cyfinfaza/RSC-LV3-Dash/changelog.md

### Revision 1

* Add SAI interface
* Expose I2C interface from CTP (no other interfaces are available on the MCU)
* Add BKLT\_ENABLE pull-down resistor (previously was only pull-up) for default dark screen
* Minor placement and silkscreen modifications
