cyfinfaza/RSC-LV3-Dash/LV3-Dash-CubeMX/pinout-formatted.csv

Position | Name | Signal | Type | Label | AF0 | AF1 | AF2 | AF3 | AF4 | AF5 | AF6 | AF7 | AF8 | AF9 | AF10 | AF11 | AF12 | AF13 | AF14
94 | BOOT0 |  | Boot
14 | NRST |  | Reset
22 | PA00 |  | I/O |  |  | TIM2_CH1/TIM2_ETR | TIM5_CH1 | TIM8_ETR | TIM15_BKIN |  |  | USART2_CTS/USART2_NSS | UART4_TX | SDMMC2_CMD | SAI2_SD_B | ETH_CRS
23 | PA01 | LTDC_R2 | I/O |  |  | TIM2_CH2 | TIM5_CH2 | LPTIM3_OUT | TIM15_CH1N |  |  | USART2_DE/USART2_RTS | UART4_RX | QUADSPI_BK1_IO3 | SAI2_MCLK_B | ETH_REF_CLK/ETH_RX_CLK |  |  | LTDC_R2
24 | PA02 | LTDC_R1 | I/O |  |  | TIM2_CH3 | TIM5_CH3 | LPTIM4_OUT | TIM15_CH1 |  |  | USART2_TX | SAI2_SCK_B |  |  | ETH_MDIO | MDIOS_MDIO |  | LTDC_R1
25 | PA03 | LTDC_B5 | I/O |  |  | TIM2_CH4 | TIM5_CH4 | LPTIM5_OUT | TIM15_CH2 |  |  | USART2_RX |  | LTDC_B2 | USB_OTG_HS_ULPI_D0 | ETH_COL |  |  | LTDC_B5
28 | PA04 | LTDC_VSYNC | I/O |  |  |  | TIM5_ETR |  |  | I2S1_WS/SPI1_NSS | I2S3_WS/SPI3_NSS | USART2_CK | SPI6_NSS |  |  |  | USB_OTG_HS_SOF | DCMI_HSYNC | LTDC_VSYNC
29 | PA05 | LTDC_R4 | I/O |  |  | TIM2_CH1/TIM2_ETR |  | TIM8_CH1N |  | I2S1_CK/SPI1_SCK |  |  | SPI6_SCK |  | USB_OTG_HS_ULPI_CK |  |  |  | LTDC_R4
30 | PA06 | LTDC_G2 | I/O |  |  | TIM1_BKIN | TIM3_CH1 | TIM8_BKIN |  | I2S1_SDI/SPI1_MISO |  |  | SPI6_MISO | TIM13_CH1 | TIM8_BKIN_COMP1/TIM8_BKIN_COMP2 | MDIOS_MDC | TIM1_BKIN_COMP1/TIM1_BKIN_COMP2 | DCMI_PIXCLK | LTDC_G2
31 | PA07 | I2S1_SDO | I/O |  |  | TIM1_CH1N | TIM3_CH2 | TIM8_CH1N |  | I2S1_SDO/SPI1_MOSI |  |  | SPI6_MOSI | TIM14_CH1 |  | ETH_CRS_DV/ETH_RX_DV | FMC_SDNWE
67 | PA08 | LTDC_R6 | I/O |  | RCC_MCO_1 | TIM1_CH1 | HRTIM_CHB2 | TIM8_BKIN2 | I2C3_SCL |  |  | USART1_CK |  |  | USB_OTG_FS_SOF | UART7_RX | TIM8_BKIN2_COMP1/TIM8_BKIN2_COMP2 | LTDC_B3 | LTDC_R6
68 | PA09 |  | I/O |  |  | TIM1_CH2 | HRTIM_CHC1 | LPUART1_TX | I2C3_SMBA | I2S2_CK/SPI2_SCK |  | USART1_TX |  |  |  | ETH_TX_ER |  | DCMI_D0 | LTDC_R5
69 | PA10 |  | I/O |  |  | TIM1_CH3 | HRTIM_CHC2 | LPUART1_RX |  |  |  | USART1_RX |  |  | USB_OTG_FS_ID | MDIOS_MDIO | LTDC_B4 | DCMI_D1 | LTDC_B1
70 | PA11 | USB_OTG_FS_DM | I/O |  |  | TIM1_CH4 | HRTIM_CHD1 | LPUART1_CTS |  | I2S2_WS/SPI2_NSS | UART4_RX | USART1_CTS/USART1_NSS |  | FDCAN1_RX | USB_OTG_FS_DM |  |  |  | LTDC_R4
71 | PA12 | USB_OTG_FS_DP | I/O |  |  | TIM1_ETR | HRTIM_CHD2 | LPUART1_DE/LPUART1_RTS |  | I2S2_CK/SPI2_SCK | UART4_TX | USART1_DE/USART1_RTS | SAI2_FS_B | FDCAN1_TX | USB_OTG_FS_DP |  |  |  | LTDC_R5
72 | PA13 (JTMS/SWDIO) | DEBUG_JTMS-SWDIO | I/O |  | DEBUG_JTMS-SWDIO
76 | PA14 (JTCK/SWCLK) | DEBUG_JTCK-SWCLK | I/O |  | DEBUG_JTCK-SWCLK
77 | PA15 (JTDI) | I2S1_WS | I/O |  | DEBUG_JTDI | TIM2_CH1/TIM2_ETR | HRTIM_FLT1 |  | CEC | I2S1_WS/SPI1_NSS | I2S3_WS/SPI3_NSS | SPI6_NSS | UART4_DE/UART4_RTS |  |  | UART7_TX
34 | PB00 | LTDC_R3 | I/O |  |  | TIM1_CH2N | TIM3_CH3 | TIM8_CH2N |  |  | DFSDM1_CKOUT |  | UART4_CTS | LTDC_R3 | USB_OTG_HS_ULPI_D1 | ETH_RXD2 |  |  | LTDC_G1
35 | PB01 | ADC1_INP5 | I/O | V_SENSE_12 |  | TIM1_CH3N | TIM3_CH4 | TIM8_CH3N |  |  | DFSDM1_DATIN1 |  |  | LTDC_R6 | USB_OTG_HS_ULPI_D2 | ETH_RXD3 |  |  | LTDC_G0
36 | PB02 |  | I/O |  | RTC_OUT_ALARM/RTC_OUT_CALIB |  | SAI1_D1 |  | DFSDM1_CKIN1 |  | SAI1_SD_A | I2S3_SDO/SPI3_MOSI | SAI4_SD_A | QUADSPI_CLK | SAI4_D1 | ETH_TX_ER
89 | PB03 (JTDO/TRACESWO) | I2S1_CK | I/O |  | DEBUG_JTDO-SWO | TIM2_CH2 | HRTIM_FLT4 |  |  | I2S1_CK/SPI1_SCK | I2S3_CK/SPI3_SCK |  | SPI6_SCK | SDMMC2_D2 | CRS_SYNC | UART7_RX
90 | PB04 (NJTRST) |  | I/O |  |  | TIM16_BKIN | TIM3_CH1 | HRTIM_EEV6 |  | I2S1_SDI/SPI1_MISO | I2S3_SDI/SPI3_MISO | I2S2_WS/SPI2_NSS | SPI6_MISO | SDMMC2_D3 |  | UART7_TX
91 | PB05 |  | I/O |  |  | TIM17_BKIN | TIM3_CH2 | HRTIM_EEV7 | I2C1_SMBA | I2S1_SDO/SPI1_MOSI | I2C4_SMBA | I2S3_SDO/SPI3_MOSI | SPI6_MOSI | FDCAN2_RX | USB_OTG_HS_ULPI_D7 | ETH_PPS_OUT | FMC_SDCKE1 | DCMI_D10 | UART5_RX
92 | PB06 | FDCAN2_TX | I/O |  |  | TIM16_CH1N | TIM4_CH1 | HRTIM_EEV8 | I2C1_SCL | CEC | I2C4_SCL | USART1_TX | LPUART1_TX | FDCAN2_TX | QUADSPI_BK1_NCS | DFSDM1_DATIN5 | FMC_SDNE1 | DCMI_D5 | UART5_TX
93 | PB07 | GPIO_Input | Input | BOOT0_SENSE |  | TIM17_CH1N | TIM4_CH2 | HRTIM_EEV9 | I2C1_SDA |  | I2C4_SDA | USART1_RX | LPUART1_RX |  |  | DFSDM1_CKIN5 | FMC_NL | DCMI_VSYNC
95 | PB08 | LTDC_B6 | I/O |  |  | TIM16_CH1 | TIM4_CH3 | DFSDM1_CKIN7 | I2C1_SCL |  | I2C4_SCL | SDMMC1_CKIN | UART4_RX | FDCAN1_RX | SDMMC2_D4 | ETH_TXD3 | SDMMC1_D4 | DCMI_D6 | LTDC_B6
96 | PB09 | LTDC_B7 | I/O |  |  | TIM17_CH1 | TIM4_CH4 | DFSDM1_DATIN7 | I2C1_SDA | I2S2_WS/SPI2_NSS | I2C4_SDA | SDMMC1_CDIR | UART4_TX | FDCAN1_TX | SDMMC2_D5 | I2C4_SMBA | SDMMC1_D5 | DCMI_D7 | LTDC_B7
46 | PB10 | LTDC_G4 | I/O |  |  | TIM2_CH3 | HRTIM_SCOUT | LPTIM2_IN1 | I2C2_SCL | I2S2_CK/SPI2_SCK | DFSDM1_DATIN7 | USART3_TX |  | QUADSPI_BK1_NCS | USB_OTG_HS_ULPI_D3 | ETH_RX_ER |  |  | LTDC_G4
47 | PB11 | LTDC_G5 | I/O |  |  | TIM2_CH4 | HRTIM_SCIN | LPTIM2_ETR | I2C2_SDA |  | DFSDM1_CKIN7 | USART3_RX |  |  | USB_OTG_HS_ULPI_D4 | ETH_TX_EN |  |  | LTDC_G5
51 | PB12 | FDCAN2_RX | I/O |  |  | TIM1_BKIN |  |  | I2C2_SMBA | I2S2_WS/SPI2_NSS | DFSDM1_DATIN1 | USART3_CK |  | FDCAN2_RX | USB_OTG_HS_ULPI_D5 | ETH_TXD0 | USB_OTG_HS_ID | TIM1_BKIN_COMP1/TIM1_BKIN_COMP2 | UART5_RX
52 | PB13 | SPI2_SCK | I/O |  |  | TIM1_CH1N |  | LPTIM2_OUT |  | I2S2_CK/SPI2_SCK | DFSDM1_CKIN1 | USART3_CTS/USART3_NSS |  | FDCAN2_TX | USB_OTG_HS_ULPI_D6 | ETH_TXD1 |  |  | UART5_TX
53 | PB14 | SPI2_MISO | I/O |  |  | TIM1_CH2N | TIM12_CH1 | TIM8_CH2N | USART1_TX | I2S2_SDI/SPI2_MISO | DFSDM1_DATIN2 | USART3_DE/USART3_RTS | UART4_DE/UART4_RTS | SDMMC2_D0 |  |  | USB_OTG_HS_DM
54 | PB15 | GPIO_Output | Output | SD_CS | RTC_REFIN | TIM1_CH3N | TIM12_CH2 | TIM8_CH3N | USART1_RX | I2S2_SDO/SPI2_MOSI | DFSDM1_CKIN2 |  | UART4_CTS | SDMMC2_D1 |  |  | USB_OTG_HS_DP
15 | PC00 | LTDC_R5 | I/O |  |  |  |  | DFSDM1_CKIN0 |  |  | DFSDM1_DATIN4 |  | SAI2_FS_B |  | USB_OTG_HS_ULPI_STP |  | FMC_SDNWE |  | LTDC_R5
16 | PC01 | SPI2_MOSI | I/O |  | DEBUG_TRACED0 |  | SAI1_D1 | DFSDM1_DATIN0 | DFSDM1_CKIN4 | I2S2_SDO/SPI2_MOSI | SAI1_SD_A |  | SAI4_SD_A | SDMMC2_CK | SAI4_D1 | ETH_MDC | MDIOS_MDC
32 | PC04 | ADC1_INP4 | I/O | V_SENSE_5 |  |  |  | DFSDM1_CKIN2 |  | I2S1_MCK |  |  |  | SPDIFRX1_IN2 |  | ETH_RXD0 | FMC_SDNE0
33 | PC05 |  | I/O |  |  |  | SAI1_D3 | DFSDM1_DATIN2 |  |  |  |  |  | SPDIFRX1_IN3 | SAI4_D3 | ETH_RXD1 | FMC_SDCKE0 | COMP1_OUT
63 | PC06 | LTDC_HSYNC | I/O |  |  | HRTIM_CHA1 | TIM3_CH1 | TIM8_CH1 | DFSDM1_CKIN3 | I2S2_MCK |  | USART6_TX | SDMMC1_D0DIR | FMC_NWAIT | SDMMC2_D6 |  | SDMMC1_D6 | DCMI_D0 | LTDC_HSYNC
64 | PC07 | LTDC_G6 | I/O |  | DEBUG_TRGIO | HRTIM_CHA2 | TIM3_CH2 | TIM8_CH2 | DFSDM1_DATIN3 |  | I2S3_MCK | USART6_RX | SDMMC1_D123DIR | FMC_NE1 | SDMMC2_D7 | SWPMI1_TX | SDMMC1_D7 | DCMI_D1 | LTDC_G6
65 | PC08 | SDMMC1_D0 | I/O |  | DEBUG_TRACED1 | HRTIM_CHB1 | TIM3_CH3 | TIM8_CH3 |  |  |  | USART6_CK | UART5_DE/UART5_RTS | FMC_NCE/FMC_NE2 |  | SWPMI1_RX | SDMMC1_D0 | DCMI_D2
66 | PC09 | SDMMC1_D1 | I/O |  | RCC_MCO_2 |  | TIM3_CH4 | TIM8_CH4 | I2C3_SDA | I2S_CKIN |  |  | UART5_CTS | QUADSPI_BK1_IO0 | LTDC_G3 | SWPMI1_SUSPEND | SDMMC1_D1 | DCMI_D3 | LTDC_B2
78 | PC10 | SDMMC1_D2 | I/O |  |  |  | HRTIM_EEV1 | DFSDM1_CKIN5 |  |  | I2S3_CK/SPI3_SCK | USART3_TX | UART4_TX | QUADSPI_BK1_IO1 |  |  | SDMMC1_D2 | DCMI_D8 | LTDC_R2
79 | PC11 | SDMMC1_D3 | I/O |  |  |  | HRTIM_FLT2 | DFSDM1_DATIN5 |  |  | I2S3_SDI/SPI3_MISO | USART3_RX | UART4_RX | QUADSPI_BK2_NCS |  |  | SDMMC1_D3 | DCMI_D4
80 | PC12 | SDMMC1_CK | I/O |  | DEBUG_TRACED3 |  | HRTIM_EEV2 |  |  |  | I2S3_SDO/SPI3_MOSI | USART3_CK | UART5_TX |  |  |  | SDMMC1_CK | DCMI_D9
7 | PC13 |  | I/O
8 | PC14-OSC32_IN (OSC32_IN) |  | I/O
9 | PC15-OSC32_OUT (OSC32_OUT) |  | I/O
17 | PC2_C | ADC3_INP0 | I/O | DPAD_A0 |  |  |  | DFSDM1_CKIN1 |  | I2S2_SDI/SPI2_MISO | DFSDM1_CKOUT |  |  |  | USB_OTG_HS_ULPI_DIR | ETH_TXD2 | FMC_SDNE0
18 | PC3_C | ADC3_INP1 | I/O | DPAD_A1 |  |  |  | DFSDM1_DATIN1 |  | I2S2_SDO/SPI2_MOSI |  |  |  |  | USB_OTG_HS_ULPI_NXT | ETH_TX_CLK | FMC_SDCKE0
81 | PD00 | UART4_RX | I/O | DPAD_RX |  |  |  | DFSDM1_CKIN6 |  |  | SAI3_SCK_A |  | UART4_RX | FDCAN1_RX |  |  | FMC_D2/FMC_DA2
82 | PD01 | UART4_TX | I/O | DPAD_TX |  |  |  | DFSDM1_DATIN6 |  |  | SAI3_SD_A |  | UART4_TX | FDCAN1_TX |  |  | FMC_D3/FMC_DA3
83 | PD02 | SDMMC1_CMD | I/O |  | DEBUG_TRACED2 |  | TIM3_ETR |  |  |  |  |  | UART5_RX |  |  |  | SDMMC1_CMD | DCMI_D11
84 | PD03 | LTDC_G7 | I/O |  |  |  |  | DFSDM1_CKOUT |  | I2S2_CK/SPI2_SCK |  | USART2_CTS/USART2_NSS |  |  |  |  | FMC_CLK | DCMI_D5 | LTDC_G7
85 | PD04 |  | I/O |  |  |  | HRTIM_FLT3 |  |  |  | SAI3_FS_A | USART2_DE/USART2_RTS |  |  |  |  | FMC_NOE
86 | PD05 |  | I/O |  |  |  | HRTIM_EEV3 |  |  |  |  | USART2_TX |  |  |  |  | FMC_NWE
87 | PD06 | LTDC_B2 | I/O |  |  |  | SAI1_D1 | DFSDM1_CKIN4 | DFSDM1_DATIN1 | I2S3_SDO/SPI3_MOSI | SAI1_SD_A | USART2_RX | SAI4_SD_A |  | SAI4_D1 | SDMMC2_CK | FMC_NWAIT | DCMI_D10 | LTDC_B2
88 | PD07 |  | I/O |  |  |  |  | DFSDM1_DATIN4 |  | I2S1_SDO/SPI1_MOSI | DFSDM1_CKIN1 | USART2_CK |  | SPDIFRX1_IN0 |  | SDMMC2_CMD | FMC_NE1
55 | PD08 | GPIO_Output | Output | SD_WP |  |  |  | DFSDM1_CKIN3 |  |  | SAI3_SCK_B | USART3_TX |  | SPDIFRX1_IN1 |  |  | FMC_D13/FMC_DA13
56 | PD09 | GPIO_Output | Output | SD_CD |  |  |  | DFSDM1_DATIN3 |  |  | SAI3_SD_B | USART3_RX |  |  |  |  | FMC_D14/FMC_DA14
57 | PD10 | LTDC_B3 | I/O |  |  |  |  | DFSDM1_CKOUT |  |  | SAI3_FS_B | USART3_CK |  |  |  |  | FMC_D15/FMC_DA15 |  | LTDC_B3
58 | PD11 | GPIO_Output | Output | LCD_EN |  |  |  | LPTIM2_IN2 | I2C4_SMBA |  |  | USART3_CTS/USART3_NSS |  | QUADSPI_BK1_IO0 | SAI2_SD_A |  | FMC_A16
59 | PD12 | I2C4_SCL | I/O | CTP_SCL |  | LPTIM1_IN1 | TIM4_CH1 | LPTIM2_IN1 | I2C4_SCL |  |  | USART3_DE/USART3_RTS |  | QUADSPI_BK1_IO1 | SAI2_FS_A |  | FMC_A17
60 | PD13 | I2C4_SDA | I/O | CTP_SDA |  | LPTIM1_OUT | TIM4_CH2 |  | I2C4_SDA |  |  |  |  | QUADSPI_BK1_IO3 | SAI2_SCK_A |  | FMC_A18
61 | PD14 | GPIO_Output | Output | CTP_INT |  |  | TIM4_CH3 |  |  |  | SAI3_MCLK_B |  | UART8_CTS |  |  |  | FMC_D0/FMC_DA0
62 | PD15 | GPIO_Output | Output | CTP_RST |  |  | TIM4_CH4 |  |  |  | SAI3_MCLK_A |  | UART8_DE/UART8_RTS |  |  |  | FMC_D1/FMC_DA1
97 | PE00 |  | I/O |  |  | LPTIM1_ETR | TIM4_ETR | HRTIM_SCIN | LPTIM2_ETR |  |  |  | UART8_RX |  | SAI2_MCLK_A |  | FMC_NBL0 | DCMI_D2
98 | PE01 |  | I/O |  |  | LPTIM1_IN2 |  | HRTIM_SCOUT |  |  |  |  | UART8_TX |  |  |  | FMC_NBL1 | DCMI_D3
1 | PE02 | GPIO_Output | Output | LED_USR | DEBUG_TRACECLK |  | SAI1_CK1 |  |  | SPI4_SCK | SAI1_MCLK_A |  | SAI4_MCLK_A | QUADSPI_BK1_IO2 | SAI4_CK1 | ETH_TXD3 | FMC_A23
2 | PE03 | GPIO_Output | Output | SD_EN | DEBUG_TRACED0 |  |  |  | TIM15_BKIN |  | SAI1_SD_B |  | SAI4_SD_B |  |  |  | FMC_A19
3 | PE04 |  | I/O |  | DEBUG_TRACED1 |  | SAI1_D2 | DFSDM1_DATIN3 | TIM15_CH1N | SPI4_NSS | SAI1_FS_A |  | SAI4_FS_A |  | SAI4_D2 |  | FMC_A20 | DCMI_D4 | LTDC_B0
4 | PE05 |  | I/O |  | DEBUG_TRACED2 |  | SAI1_CK2 | DFSDM1_CKIN3 | TIM15_CH1 | SPI4_MISO | SAI1_SCK_A |  | SAI4_SCK_A |  | SAI4_CK2 |  | FMC_A21 | DCMI_D6 | LTDC_G0
5 | PE06 |  | I/O |  | DEBUG_TRACED3 | TIM1_BKIN2 | SAI1_D1 |  | TIM15_CH2 | SPI4_MOSI | SAI1_SD_A |  | SAI4_SD_A | SAI4_D1 | SAI2_MCLK_B | TIM1_BKIN2_COMP1/TIM1_BKIN2_COMP2 | FMC_A22 | DCMI_D7 | LTDC_G1
37 | PE07 |  | I/O |  |  | TIM1_ETR |  | DFSDM1_DATIN2 |  |  |  | UART7_RX |  |  | QUADSPI_BK2_IO0 |  | FMC_D4/FMC_DA4
38 | PE08 |  | I/O |  |  | TIM1_CH1N |  | DFSDM1_CKIN2 |  |  |  | UART7_TX |  |  | QUADSPI_BK2_IO1 |  | FMC_D5/FMC_DA5 | COMP2_OUT
39 | PE09 | TIM1_CH1 | I/O | BKLT_CTRL |  | TIM1_CH1 |  | DFSDM1_CKOUT |  |  |  | UART7_DE/UART7_RTS |  |  | QUADSPI_BK2_IO2 |  | FMC_D6/FMC_DA6
40 | PE10 | GPIO_Output | Output | LCD_EN |  | TIM1_CH2N |  | DFSDM1_DATIN4 |  |  |  | UART7_CTS |  |  | QUADSPI_BK2_IO3 |  | FMC_D7/FMC_DA7
41 | PE11 | LTDC_G3 | I/O |  |  | TIM1_CH2 |  | DFSDM1_CKIN4 |  | SPI4_NSS |  |  |  |  | SAI2_SD_B |  | FMC_D8/FMC_DA8 |  | LTDC_G3
42 | PE12 | LTDC_B4 | I/O |  |  | TIM1_CH3N |  | DFSDM1_DATIN5 |  | SPI4_SCK |  |  |  |  | SAI2_SCK_B |  | FMC_D9/FMC_DA9 | COMP1_OUT | LTDC_B4
43 | PE13 | LTDC_DE | I/O |  |  | TIM1_CH3 |  | DFSDM1_CKIN5 |  | SPI4_MISO |  |  |  |  | SAI2_FS_B |  | FMC_D10/FMC_DA10 | COMP2_OUT | LTDC_DE
44 | PE14 | LTDC_CLK | I/O |  |  | TIM1_CH4 |  |  |  | SPI4_MOSI |  |  |  |  | SAI2_MCLK_B |  | FMC_D11/FMC_DA11 |  | LTDC_CLK
45 | PE15 | LTDC_R7 | I/O |  |  | TIM1_BKIN |  |  |  |  |  |  |  |  |  |  | FMC_D12/FMC_DA12 | TIM1_BKIN_COMP1/TIM1_BKIN_COMP2 | LTDC_R7
12 | PH0-OSC_IN (PH0) | RCC_OSC_IN | I/O
13 | PH1-OSC_OUT (PH1) | RCC_OSC_OUT | I/O
6 | VBAT |  | Power
48 | VCAP |  | Power
73 | VCAP |  | Power
11 | VDD |  | Power
27 | VDD |  | Power
50 | VDD |  | Power
75 | VDD |  | Power
100 | VDD |  | Power
21 | VDDA |  | Power
20 | VREF+ |  | MonoIO
10 | VSS |  | Power
26 | VSS |  | Power
49 | VSS |  | Power
74 | VSS |  | Power
99 | VSS |  | Power
19 | VSSA |  | Power
