cyfinfaza/RSC-LV3-Dash/(list of files, drawings)

Other design files:
LV3-Dash.dsn
