cyfinfaza/RSC-LV3-Dash/LV3-Dash.kicad_pcb

## KiCad design LV3-Dash.kicad_pcb (2026-03-30)

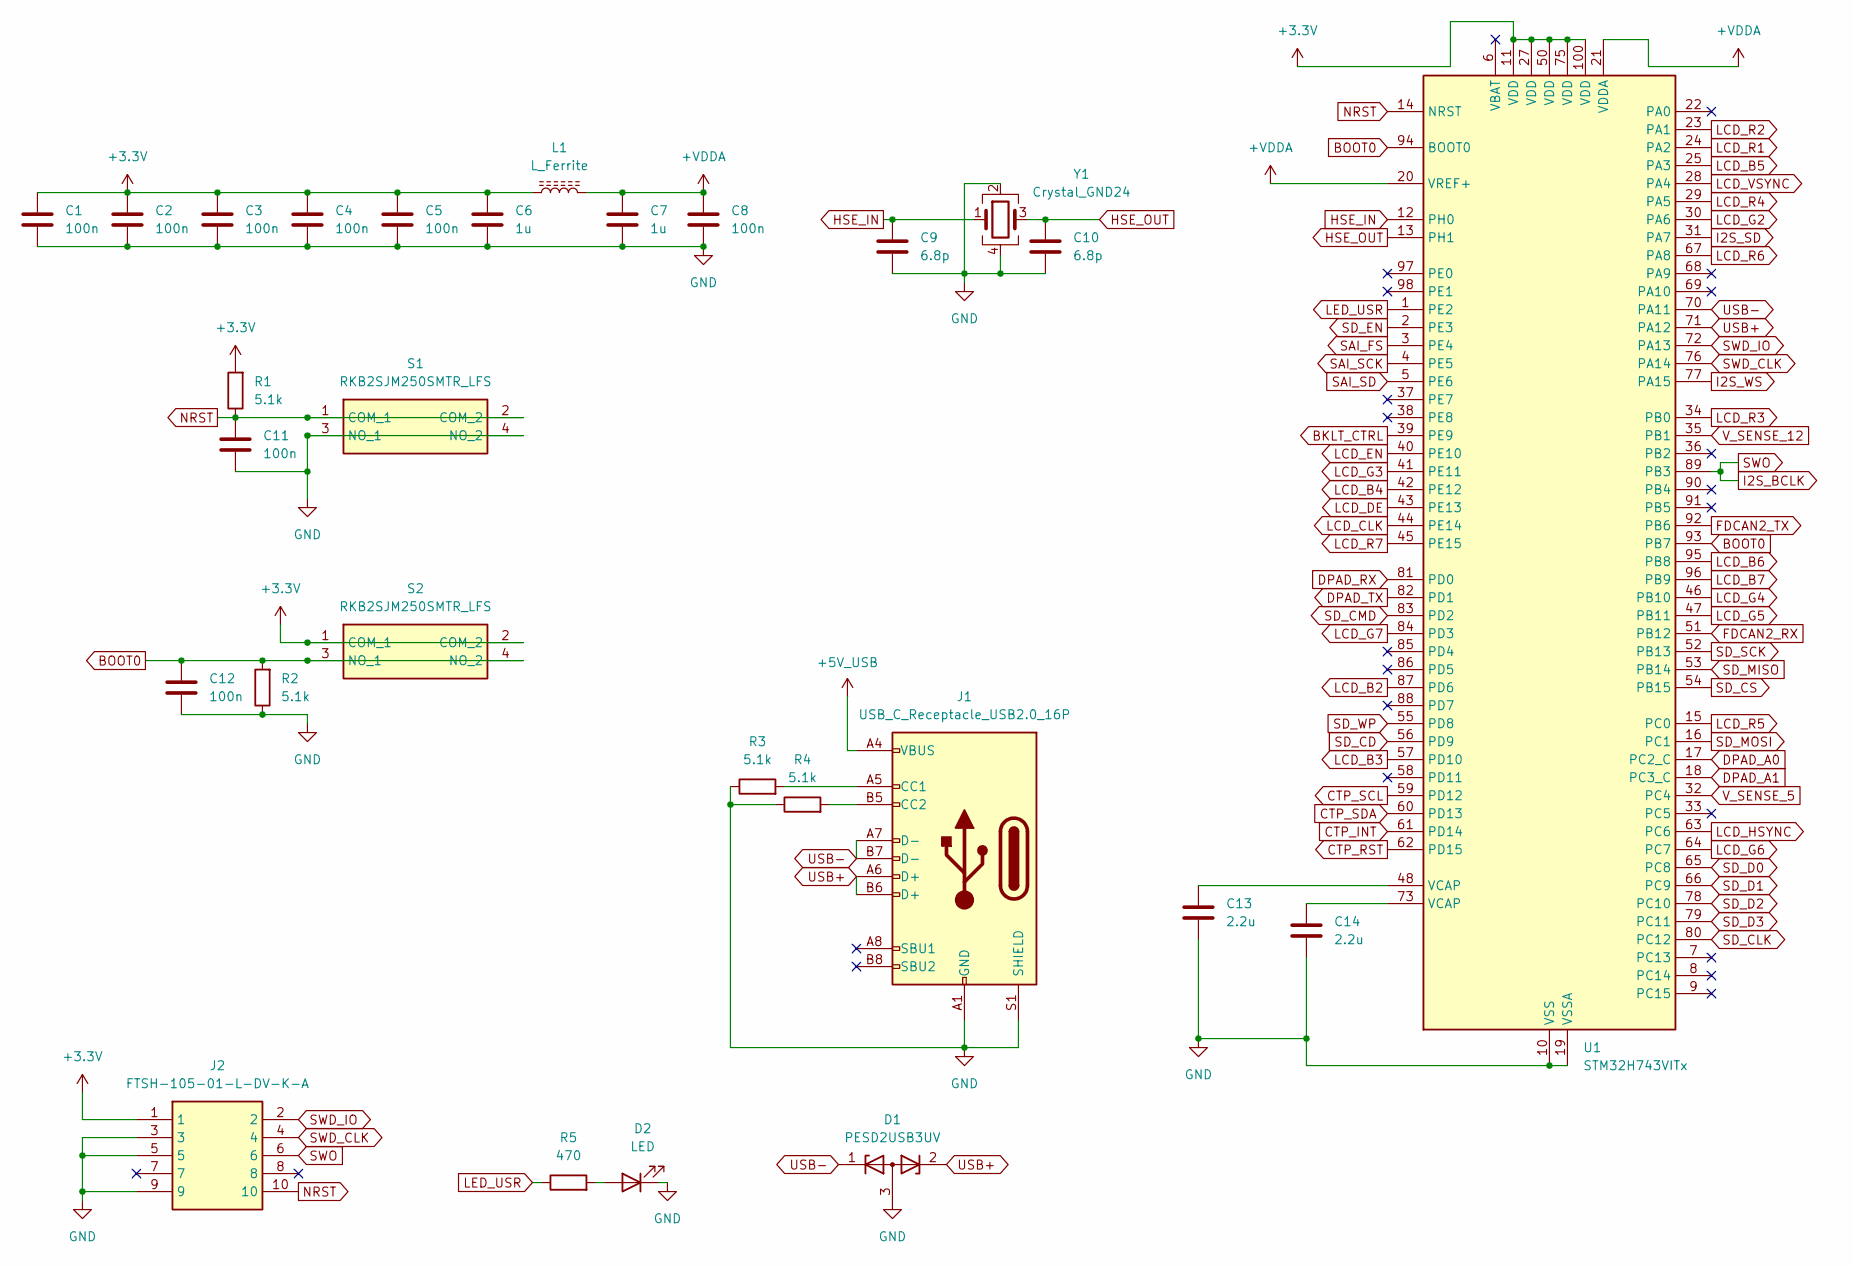
[picture p1: schematic MCU.kicad_sch]

Parts:
C1, C2, C3, C4, C5, C8, C11, C12: 100n; C_0603_1608Metric_Pad1.08x0.95mm_HandSolder
C6, C7: 1u; C_0603_1608Metric_Pad1.08x0.95mm_HandSolder
C9, C10: 6.8p; C_0603_1608Metric_Pad1.08x0.95mm_HandSolder
C13, C14: 2.2u; C_0603_1608Metric_Pad1.08x0.95mm_HandSolder
D1: PESD2USB3UV; SOT-23W
D2: LED; LED_0603_1608Metric_Pad1.05x0.95mm_HandSolder
J1: USB_C_Receptacle_USB2.0_16P; USB_C_Receptacle_HRO_TYPE-C-31-M-12
J2: FTSH-105-01-L-DV-K-A; FTSH-105-XX-YYY-DV-K-A; Mouser Part Number 200-FTSH10501LDVKA
L1: L_Ferrite; L_0603_1608Metric_Pad1.05x0.95mm_HandSolder
R1, R2, R3, R4: 5.1k; R_0603_1608Metric_Pad0.98x0.95mm_HandSolder
R5: 470; R_0603_1608Metric_Pad0.98x0.95mm_HandSolder
S1, S2: RKB2SJM250SMTR_LFS; RKB2SJM250SMTRLFS; Mouser Part Number 611-RKB2SJM250SMTRLF
U1: STM32H743VITx; LQFP-100_14x14mm_P0.5mm
Y1: Crystal_GND24; Crystal_SMD_3225-4Pin_3.2x2.5mm

Connections:
+3.3V: C1.1, C2.1, C3.1, C4.1, C5.1, C6.1, J2.1, L1.1, R1.2, S2.1 (COM_1), S2.2 (COM_2), U1.11 (VDD), U1.27 (VDD), U1.50 (VDD), U1.75 (VDD), U1.100 (VDD); also elsewhere on the board
+5V_USB: J1.A4 (VBUS), J1.A9 (VBUS), J1.B4 (VBUS), J1.B9 (VBUS); also elsewhere on the board
+VDDA: C7.1, C8.1, L1.2, U1.20 (VREF+), U1.21 (VDDA)
BKLT_CTRL: U1.39 (PE9); also elsewhere on the board
BOOT0: C12.1, R2.2, S2.3 (NO_1), S2.4 (NO_2), U1.93 (PB7), U1.94 (BOOT0)
CTP_INT: U1.61 (PD14); also elsewhere on the board
CTP_RST: U1.62 (PD15); also elsewhere on the board
CTP_SCL: U1.59 (PD12); also elsewhere on the board
CTP_SDA: U1.60 (PD13); also elsewhere on the board
DPAD_A0: U1.17 (PC2_C), U1.82 (PD1); also elsewhere on the board
DPAD_A1: U1.18 (PC3_C), U1.81 (PD0); also elsewhere on the board
FDCAN2_RX: U1.51 (PB12); also elsewhere on the board
FDCAN2_TX: U1.92 (PB6); also elsewhere on the board
GND: C1.2, C2.2, C3.2, C4.2, C5.2, C6.2, C7.2, C8.2, C9.2, C10.2, C11.2, C12.2, C13.2, C14.2, D1.3 (A), D2.1 (K), J1.A1 (GND), J1.A12 (GND), J1.B1 (GND), J1.B12 (GND), J1.S1 (SHIELD), J2.3, J2.5, J2.9, R2.1, R3.1, R4.1, S1.3 (NO_1), S1.4 (NO_2), U1.10 (VSS), U1.19 (VSSA), U1.26 (VSS), U1.49 (VSS), U1.74 (VSS), U1.99 (VSS), Y1.2, Y1.4; also elsewhere on the board
HSE_IN: C9.1, U1.12 (PH0), Y1.1
HSE_OUT: C10.1, U1.13 (PH1), Y1.3
I2S_BCLK: J2.6, U1.89 (PB3); also elsewhere on the board
I2S_SD: U1.31 (PA7); also elsewhere on the board
I2S_WS: U1.77 (PA15); also elsewhere on the board
LCD_B2: U1.87 (PD6); also elsewhere on the board
LCD_B3: U1.57 (PD10); also elsewhere on the board
LCD_B4: U1.42 (PE12); also elsewhere on the board
LCD_B5: U1.25 (PA3); also elsewhere on the board
LCD_B6: U1.95 (PB8); also elsewhere on the board
LCD_B7: U1.96 (PB9); also elsewhere on the board
LCD_CLK: U1.44 (PE14); also elsewhere on the board
LCD_DE: U1.43 (PE13); also elsewhere on the board
LCD_EN: U1.40 (PE10); also elsewhere on the board
LCD_G2: U1.30 (PA6); also elsewhere on the board
LCD_G3: U1.41 (PE11); also elsewhere on the board
LCD_G4: U1.46 (PB10); also elsewhere on the board
LCD_G5: U1.47 (PB11); also elsewhere on the board
LCD_G6: U1.64 (PC7); also elsewhere on the board
LCD_G7: U1.84 (PD3); also elsewhere on the board
LCD_HSYNC: U1.63 (PC6); also elsewhere on the board
LCD_R1: U1.24 (PA2)
LCD_R2: U1.23 (PA1); also elsewhere on the board
LCD_R3: U1.34 (PB0); also elsewhere on the board
LCD_R4: U1.29 (PA5); also elsewhere on the board
LCD_R5: U1.15 (PC0); also elsewhere on the board
LCD_R6: U1.67 (PA8); also elsewhere on the board
LCD_R7: U1.45 (PE15); also elsewhere on the board
LCD_VSYNC: U1.28 (PA4); also elsewhere on the board
LED_USR: R5.1, U1.1 (PE2)
NRST: C11.1, J2.10, R1.1, S1.1 (COM_1), S1.2 (COM_2), U1.14 (NRST)
unnamed: C13.1, U1.48 (VCAP)
unnamed: C14.1, U1.73 (VCAP)
unnamed: D2.2 (A), R5.2
unnamed: J1.A5 (CC1), R3.2
unnamed: J1.B5 (CC2), R4.2
SAI_FS: U1.3 (PE4); also elsewhere on the board
SAI_SCK: U1.4 (PE5); also elsewhere on the board
SAI_SD: U1.5 (PE6); also elsewhere on the board
SD_CD: U1.56 (PD9); also elsewhere on the board
SD_CLK: U1.52 (PB13), U1.80 (PC12); also elsewhere on the board
SD_CMD: U1.16 (PC1), U1.83 (PD2); also elsewhere on the board
SD_CS: U1.54 (PB15), U1.79 (PC11); also elsewhere on the board
SD_D0: U1.53 (PB14), U1.65 (PC8); also elsewhere on the board
SD_D1: U1.66 (PC9); also elsewhere on the board
SD_D2: U1.78 (PC10); also elsewhere on the board
SD_EN: U1.2 (PE3); also elsewhere on the board
SD_WP: U1.55 (PD8); also elsewhere on the board
SWD_CLK: J2.4, U1.76 (PA14)
SWD_IO: J2.2, U1.72 (PA13)
USB+: D1.2 (K), J1.A6 (D+), J1.B6 (D+), U1.71 (PA12)
USB-: D1.1 (K), J1.A7 (D-), J1.B7 (D-), U1.70 (PA11)
V_SENSE_5: U1.32 (PC4); also elsewhere on the board
V_SENSE_12: U1.35 (PB1); also elsewhere on the board

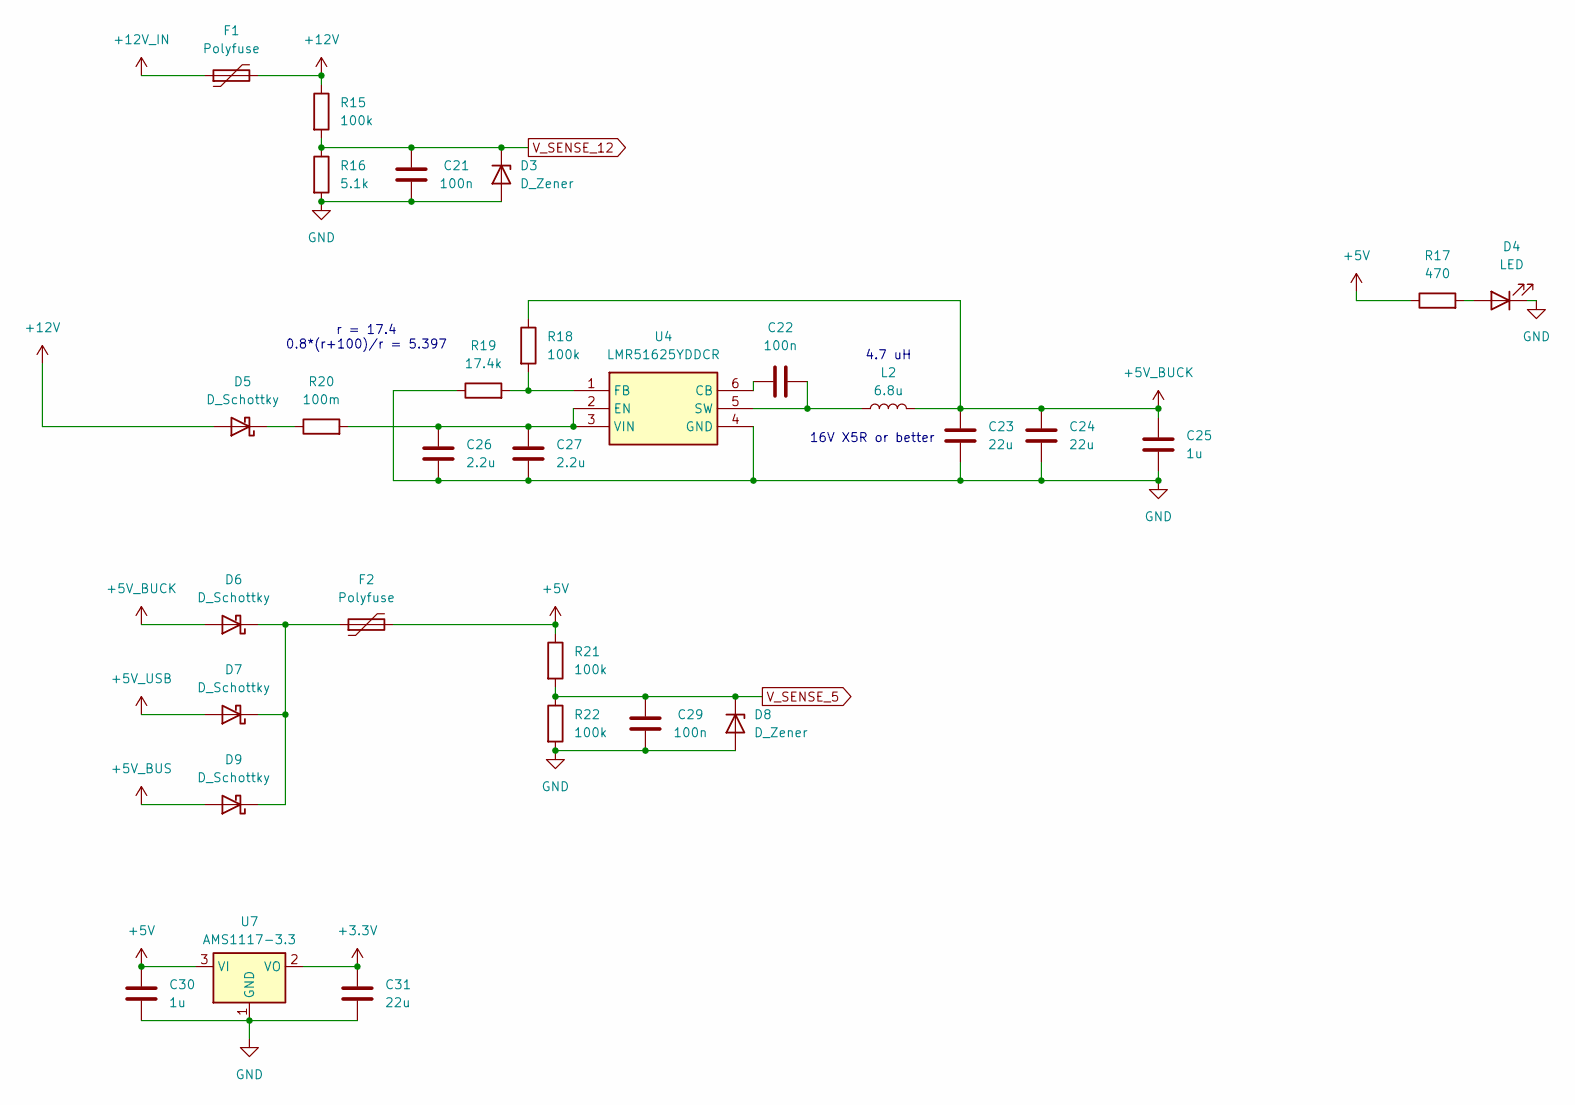
[picture p2: schematic Power.kicad_sch]

Parts:
C21, C22, C29: 100n; C_0603_1608Metric_Pad1.08x0.95mm_HandSolder
C23, C24, C31: 22u; C_1206_3216Metric_Pad1.33x1.80mm_HandSolder
C25, C30: 1u; C_0603_1608Metric_Pad1.08x0.95mm_HandSolder
C26, C27: 2.2u; C_0603_1608Metric_Pad1.08x0.95mm_HandSolder
D3, D8: D_Zener; D_SOD-323_HandSoldering
D4: LED; LED_0603_1608Metric_Pad1.05x0.95mm_HandSolder
D5, D6, D7, D9: D_Schottky; D_SOD-123F
F1, F2: Polyfuse; Fuse_1812_4532Metric_Pad1.30x3.40mm_HandSolder
L2: 6.8u; L_Bourns-SRN4018
R15, R18, R21, R22: 100k; R_0603_1608Metric_Pad0.98x0.95mm_HandSolder
R16: 5.1k; R_0603_1608Metric_Pad0.98x0.95mm_HandSolder
R17: 470; R_0603_1608Metric_Pad0.98x0.95mm_HandSolder
R19: 17.4k; R_0603_1608Metric_Pad0.98x0.95mm_HandSolder
R20: 100m; R_1206_3216Metric_Pad1.30x1.75mm_HandSolder
U4: LMR51625YDDCR; SOT95P280X110-6N; Manufacturer_Part_Number LMR51625YFDDCR; Mouser Part Number 595-LMR51625YFDDCR
U7: AMS1117-3.3; SOT-223-3_TabPin2

Connections:
+3.3V: C31.1, U7.2 (VO); also elsewhere on the board
+5V: C30.1, F2.2, R17.1, R21.1, U7.3 (VI); also elsewhere on the board
+5V_BUCK: C23.1, C24.1, C25.1, D6.2 (A), L2.2, R18.1
+5V_BUS: D9.2 (A); also elsewhere on the board
+5V_USB: D7.2 (A); also elsewhere on the board
+12V: D5.2 (A), F1.2, R15.1
+12V_IN: F1.1; also elsewhere on the board
GND: C21.2, C23.2, C24.2, C25.2, C26.2, C27.2, C29.2, C30.2, C31.2, D3.2 (A), D4.1 (K), D8.2 (A), R16.2, R19.1, R22.2, U4.4 (GND), U7.1 (GND); also elsewhere on the board
unnamed: D4.2 (A), R17.2
unnamed: D5.1 (K), R20.1
unnamed: D6.1 (K), D7.1 (K), D9.1 (K), F2.1
unnamed: C22.1, U4.6 (CB)
unnamed: C26.1, C27.1, R20.2, U4.2 (EN), U4.3 (VIN)
unnamed: R18.2, R19.2, U4.1 (FB)
unnamed: C22.2, L2.1, U4.5 (SW)
V_SENSE_5: C29.1, D8.1 (K), R21.2, R22.1; also elsewhere on the board
V_SENSE_12: C21.1, D3.1 (K), R15.2, R16.1; also elsewhere on the board

Notes on the sheet:
16V X5R or better
4.7 uH
r = 17.4 0.8*(r+100)/r = 5.397

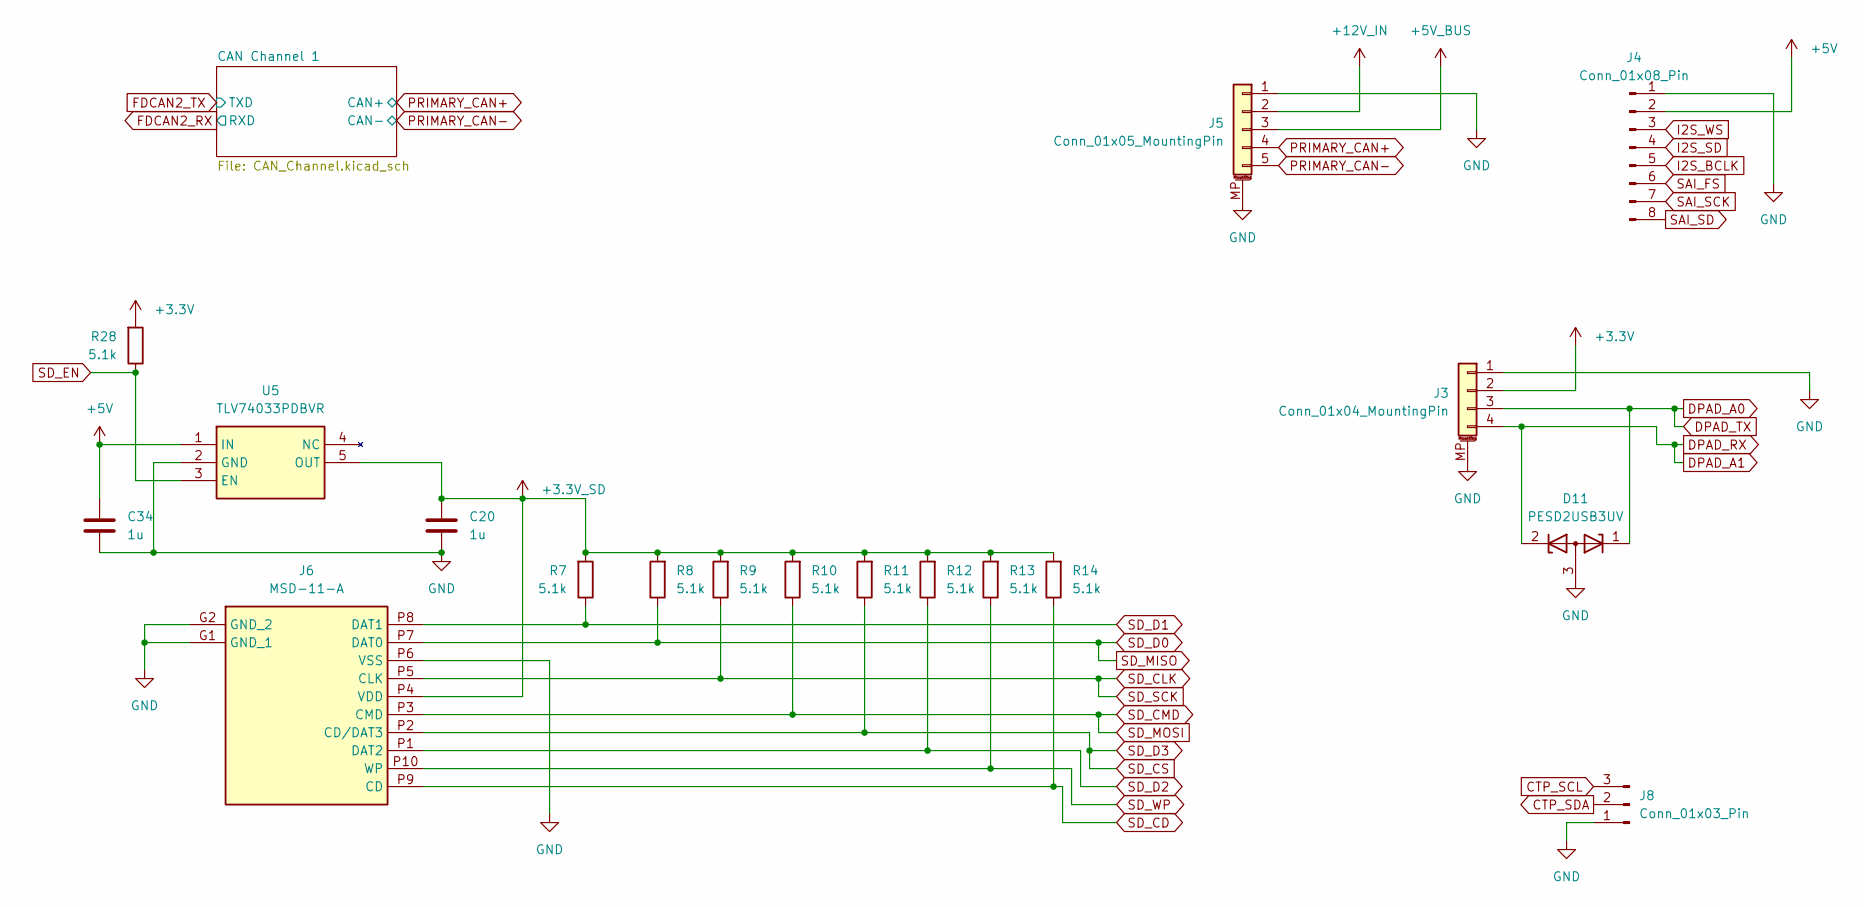
[picture p3: schematic Interfaces.kicad_sch]

Parts:
C20, C34: 1u; C_0603_1608Metric_Pad1.08x0.95mm_HandSolder
D11: PESD2USB3UV; SOT-23W
J3: Conn_01x04_MountingPin; Molex_Micro-Fit_3.0_43650-0410_1x04-1MP_P3.00mm_Horizontal
J4: Conn_01x08_Pin; PinHeader_1x08_P2.54mm_Vertical
J5: Conn_01x05_MountingPin; Molex_Micro-Fit_3.0_43650-0510_1x05-1MP_P3.00mm_Horizontal
J6: MSD-11-A; MSD11A; Mouser Part Number 179-MSD-11-A
J8: Conn_01x03_Pin; PinHeader_1x03_P2.54mm_Vertical
R7, R8, R9, R10, R11, R12, R13, R14, R28: 5.1k; R_0603_1608Metric_Pad0.98x0.95mm_HandSolder
U5: TLV74033PDBVR; SOT95P280X145-5N; Mouser Part Number 595-TLV74033PDBVR

Connections:
+3.3V: J3.2, R28.2; also elsewhere on the board
+3.3V_SD: C20.1, J6.P4 (VDD), R7.2, R8.2, R9.2, R10.2, R11.2, R12.2, R13.2, R14.2, U5.5 (OUT)
+5V: C34.1, J4.2, U5.1 (IN); also elsewhere on the board
+5V_BUS: J5.3; also elsewhere on the board
+12V_IN: J5.2; also elsewhere on the board
CTP_SCL: J8.3; also elsewhere on the board
CTP_SDA: J8.2; also elsewhere on the board
DPAD_A0: D11.1 (K), J3.3; also elsewhere on the board
DPAD_A1: D11.2 (K), J3.4; also elsewhere on the board
GND: C20.2, C34.2, D11.3 (A), J3.1, J3.MP (MountPin), J4.1, J5.1, J5.MP (MountPin), J6.G1 (GND_1), J6.G2 (GND_2), J6.P6 (VSS), J8.1, U5.2 (GND); also elsewhere on the board
I2S_BCLK: J4.5; also elsewhere on the board
I2S_SD: J4.4; also elsewhere on the board
I2S_WS: J4.3; also elsewhere on the board
PRIMARY_CAN+: J5.4; also elsewhere on the board
PRIMARY_CAN-: J5.5; also elsewhere on the board
SAI_FS: J4.6; also elsewhere on the board
SAI_SCK: J4.7; also elsewhere on the board
SAI_SD: J4.8; also elsewhere on the board
SD_CD: J6.P9 (CD), R14.1; also elsewhere on the board
SD_CLK: J6.P5 (CLK), R9.1; also elsewhere on the board
SD_CMD: J6.P3 (CMD), R10.1; also elsewhere on the board
SD_CS: J6.P2 (CD/DAT3), R11.1; also elsewhere on the board
SD_D0: J6.P7 (DAT0), R8.1; also elsewhere on the board
SD_D1: J6.P8 (DAT1), R7.1; also elsewhere on the board
SD_D2: J6.P1 (DAT2), R12.1; also elsewhere on the board
SD_EN: R28.1, U5.3 (EN); also elsewhere on the board
SD_WP: J6.P10 (WP), R13.1; also elsewhere on the board

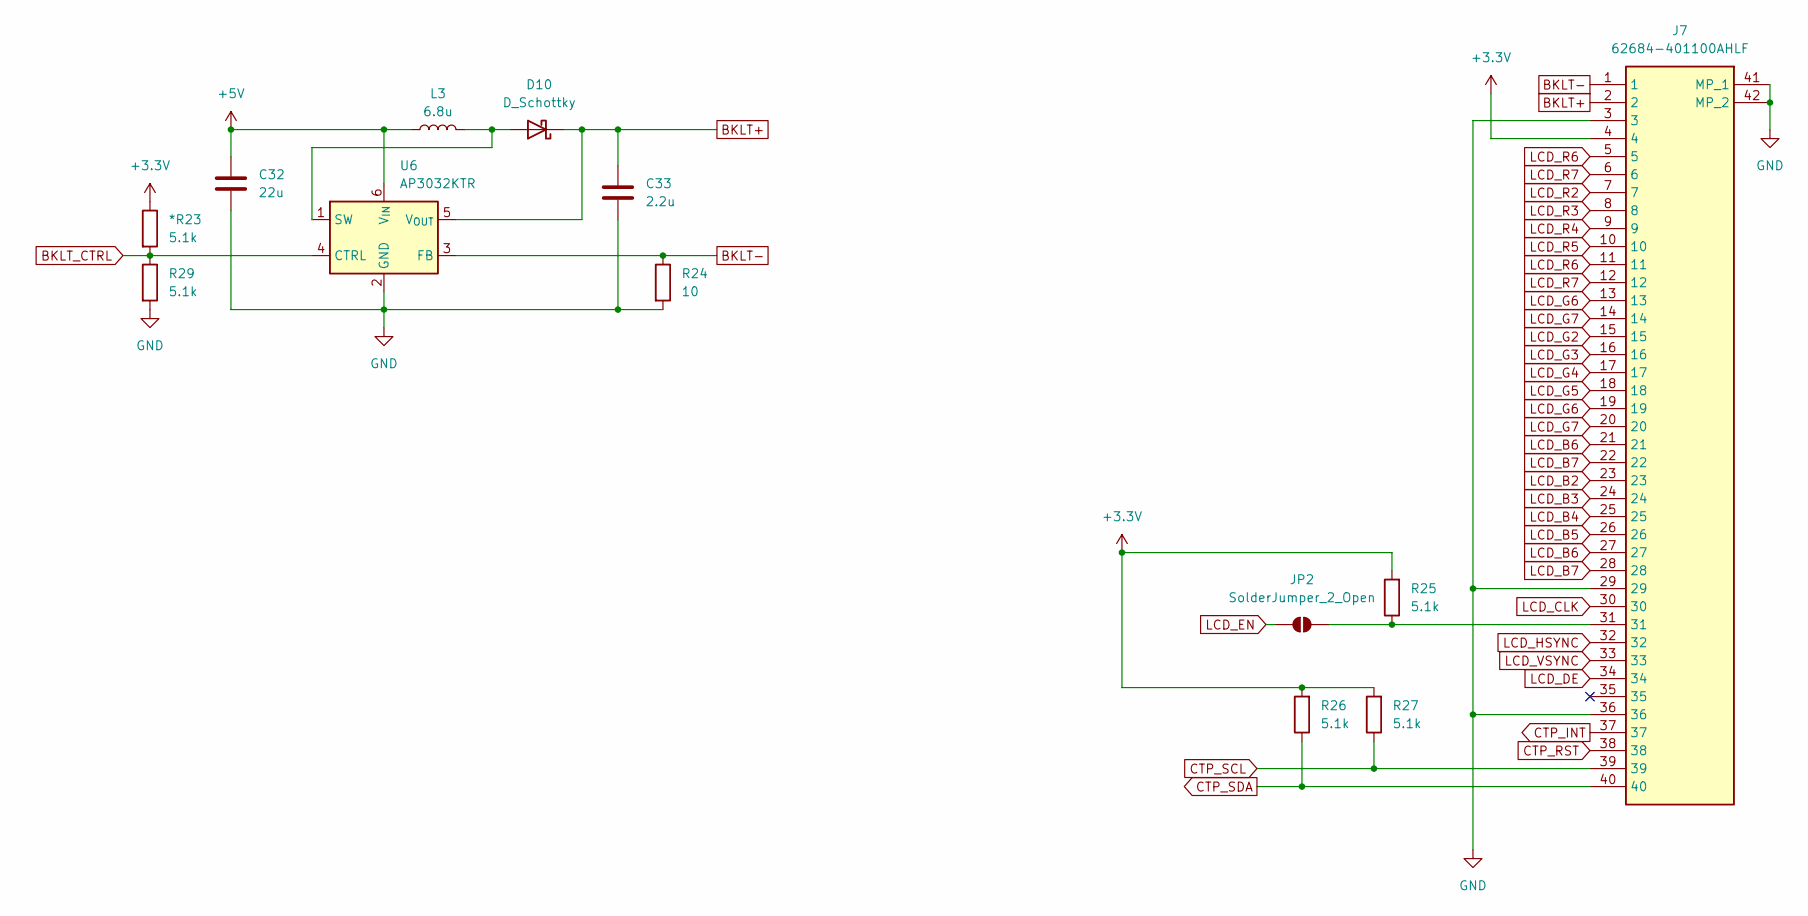
[picture p4: schematic LCD.kicad_sch]

Parts:
*R23: 5.1k; R_0603_1608Metric_Pad0.98x0.95mm_HandSolder
C32: 22u; C_1206_3216Metric_Pad1.33x1.80mm_HandSolder
C33: 2.2u; C_0603_1608Metric_Pad1.08x0.95mm_HandSolder
D10: D_Schottky; D_SOD-123F
J7: 62684-401100AHLF; 62684401100AHLF; Mouser Part Number 649-62684-401100AHLF
JP2: SolderJumper_2_Open; SolderJumper-2_P1.3mm_Open_RoundedPad1.0x1.5mm
L3: 6.8u; L_Bourns-SRN4018
R24: 10; R_0603_1608Metric_Pad0.98x0.95mm_HandSolder
R25, R26, R27, R29: 5.1k; R_0603_1608Metric_Pad0.98x0.95mm_HandSolder
U6: AP3032KTR; SOT-23-6

Connections:
+3.3V: *R23.1, J7.4, R25.2, R26.2, R27.2; also elsewhere on the board
+5V: C32.1, L3.1, U6.6 (V_{IN}); also elsewhere on the board
BKLT+: C33.1, D10.1 (K), J7.2, U6.5 (V_{OUT})
BKLT-: J7.1, R24.1, U6.3 (FB)
BKLT_CTRL: *R23.2, R29.1, U6.4 (CTRL); also elsewhere on the board
CTP_INT: J7.37; also elsewhere on the board
CTP_RST: J7.38; also elsewhere on the board
CTP_SCL: J7.39, R27.1; also elsewhere on the board
CTP_SDA: J7.40, R26.1; also elsewhere on the board
GND: C32.2, C33.2, J7.3, J7.29, J7.36, J7.41 (MP_1), J7.42 (MP_2), R24.2, R29.2, U6.2 (GND); also elsewhere on the board
LCD_B2: J7.23; also elsewhere on the board
LCD_B3: J7.24; also elsewhere on the board
LCD_B4: J7.25; also elsewhere on the board
LCD_B5: J7.26; also elsewhere on the board
LCD_B6: J7.21, J7.27; also elsewhere on the board
LCD_B7: J7.22, J7.28; also elsewhere on the board
LCD_CLK: J7.30; also elsewhere on the board
LCD_DE: J7.34; also elsewhere on the board
LCD_EN: JP2.1 (A); also elsewhere on the board
LCD_G2: J7.15; also elsewhere on the board
LCD_G3: J7.16; also elsewhere on the board
LCD_G4: J7.17; also elsewhere on the board
LCD_G5: J7.18; also elsewhere on the board
LCD_G6: J7.13, J7.19; also elsewhere on the board
LCD_G7: J7.14, J7.20; also elsewhere on the board
LCD_HSYNC: J7.32; also elsewhere on the board
LCD_R2: J7.7; also elsewhere on the board
LCD_R3: J7.8; also elsewhere on the board
LCD_R4: J7.9; also elsewhere on the board
LCD_R5: J7.10; also elsewhere on the board
LCD_R6: J7.5, J7.11; also elsewhere on the board
LCD_R7: J7.6, J7.12; also elsewhere on the board
LCD_VSYNC: J7.33; also elsewhere on the board
unnamed: D10.2 (A), L3.2, U6.1 (SW)
unnamed: J7.31, JP2.2 (B), R25.1

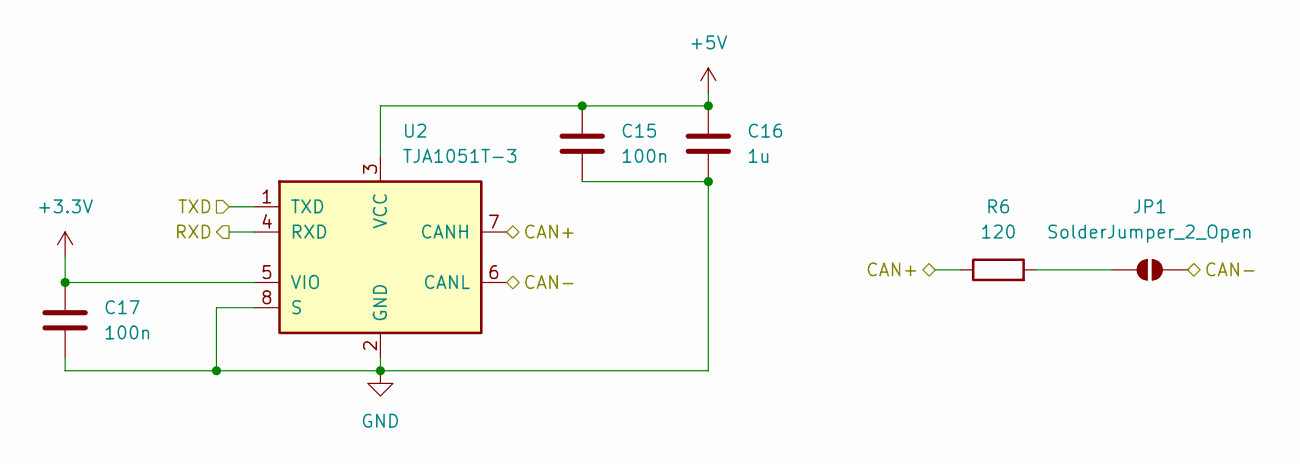
[picture p5: schematic CAN_Channel.kicad_sch]

Parts:
C15, C17: 100n; C_0603_1608Metric_Pad1.08x0.95mm_HandSolder
C16: 1u; C_0603_1608Metric_Pad1.08x0.95mm_HandSolder
JP1: SolderJumper_2_Open; SolderJumper-2_P1.3mm_Open_RoundedPad1.0x1.5mm
R6: 120; R_0603_1608Metric_Pad0.98x0.95mm_HandSolder
U2: TJA1051T-3; SOIC-8_3.9x4.9mm_P1.27mm

Connections:
+3.3V: C17.1, U2.5 (VIO); also elsewhere on the board
+5V: C15.1, C16.1, U2.3 (VCC); also elsewhere on the board
FDCAN2_RX: U2.4 (RXD); also elsewhere on the board
FDCAN2_TX: U2.1 (TXD); also elsewhere on the board
GND: C15.2, C16.2, C17.2, U2.2 (GND), U2.8 (S); also elsewhere on the board
unnamed: JP1.1 (A), R6.2
PRIMARY_CAN+: R6.1, U2.7 (CANH); also elsewhere on the board
PRIMARY_CAN-: JP1.2 (B), U2.6 (CANL); also elsewhere on the board

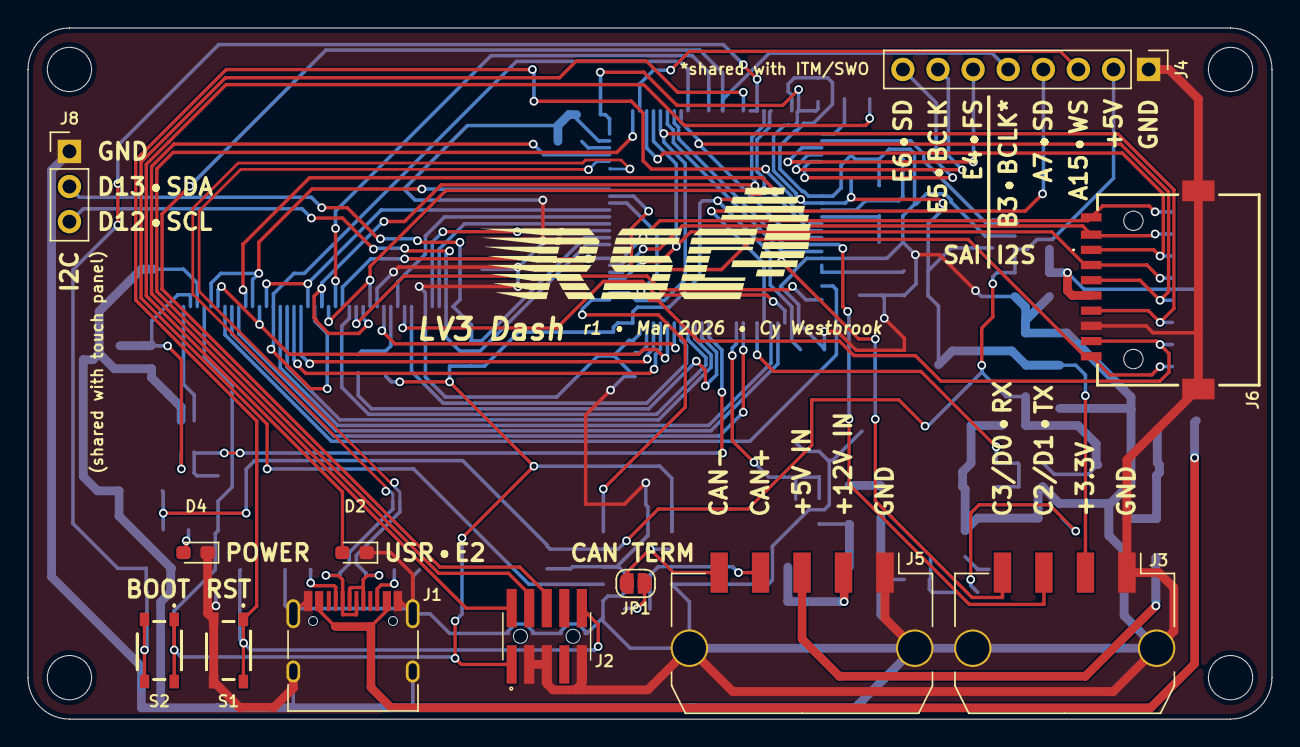
[picture p6: board LV3-Dash.kicad_pcb from above]

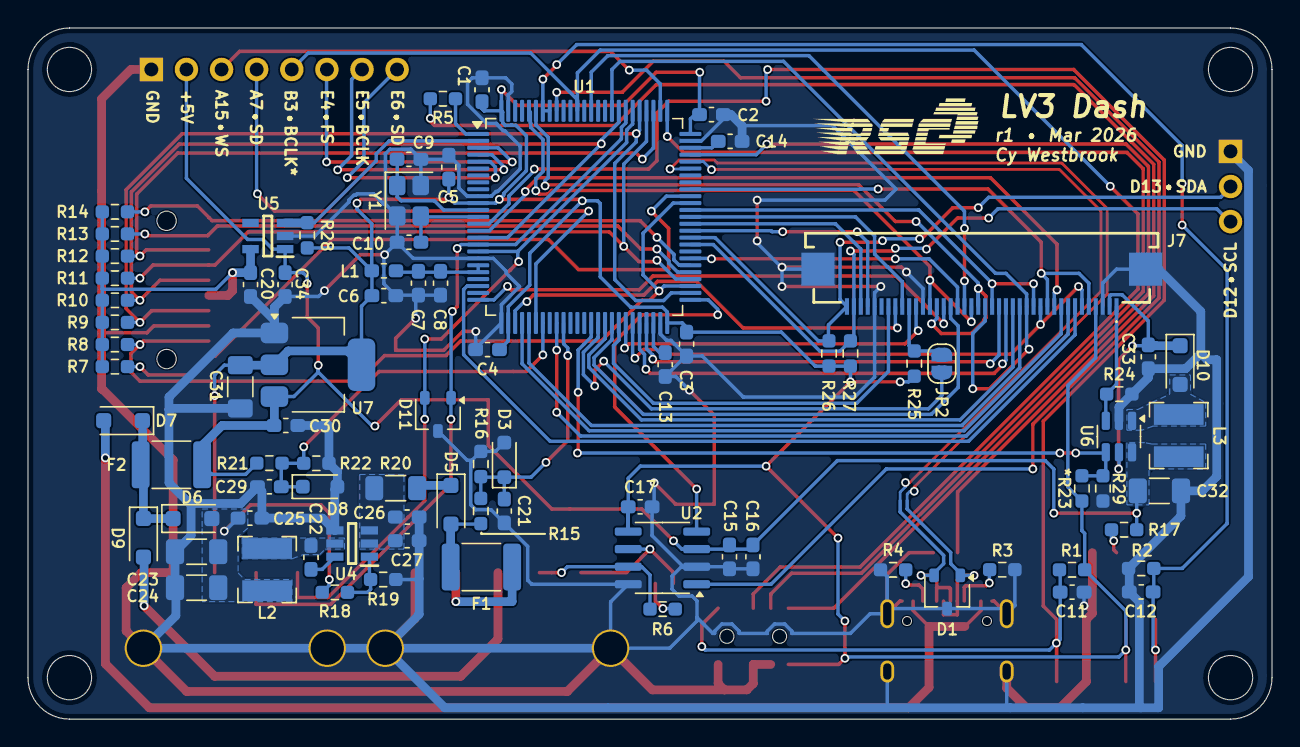
[picture p7: board LV3-Dash.kicad_pcb from below]

Board: 2 copper layers, 90.0 x 50.0 mm, 95 parts (83 on the bottom side), 87 nets.
