cyfinfaza/RSC-LV3-Dash/LV3-Dash-CubeMX/LV3-Dash-CubeMX.ioc

Mcu.UserName=STM32H743VITx
PA1.Signal=LTDC_R2
PA11.Signal=USB_OTG_FS_DM
PA12.Signal=USB_OTG_FS_DP
PA2.Signal=LTDC_R1
PA3.Signal=LTDC_B5
PA4.Signal=LTDC_VSYNC
PA5.Signal=LTDC_R4
PA6.Signal=LTDC_G2
PA7.Signal=I2S1_SDO
PA8.Signal=LTDC_R6
PB0.Signal=LTDC_R3
PB1.GPIO_Label=V_SENSE_12
PB1.Signal=ADCx_INP5
PB10.Signal=LTDC_G4
PB11.Signal=LTDC_G5
PB12.Signal=FDCAN2_RX
PB13.Signal=SPI2_SCK
PB14.Signal=SPI2_MISO
PB15.GPIO_Label=SD_CS
PB15.Signal=GPIO_Output
PB6.Signal=FDCAN2_TX
PB7.GPIO_Label=BOOT0_SENSE
PB7.Signal=GPIO_Input
PB8.Signal=LTDC_B6
PB9.Signal=LTDC_B7
PC0.Signal=LTDC_R5
PC1.Signal=SPI2_MOSI
PC10.Signal=SDMMC1_D2
PC11.Signal=SDMMC1_D3
PC12.Signal=SDMMC1_CK
PC2_C.GPIO_Label=DPAD_A0
PC2_C.Signal=ADC3_INP0
PC3_C.GPIO_Label=DPAD_A1
PC3_C.Signal=ADC3_INP1
PC4.GPIO_Label=V_SENSE_5
PC4.Signal=ADCx_INP4
PC6.Signal=LTDC_HSYNC
PC7.Signal=LTDC_G6
PC8.Signal=SDMMC1_D0
PC9.Signal=SDMMC1_D1
PD0.GPIO_Label=DPAD_RX
PD0.Signal=UART4_RX
PD1.GPIO_Label=DPAD_TX
PD1.Signal=UART4_TX
PD10.Signal=LTDC_B3
PD12.GPIO_Label=CTP_SCL
PD12.Signal=I2C4_SCL
PD13.GPIO_Label=CTP_SDA
PD13.Signal=I2C4_SDA
PD14.GPIO_Label=CTP_INT
PD14.Signal=GPIO_Output
PD15.GPIO_Label=CTP_RST
PD15.Signal=GPIO_Output
PD2.Signal=SDMMC1_CMD
PD3.Signal=LTDC_G7
PD6.Signal=LTDC_B2
PD8.GPIO_Label=SD_WP
PD8.Signal=GPIO_Output
PD9.GPIO_Label=SD_CD
PD9.Signal=GPIO_Output
PE10.GPIO_Label=LCD_EN
PE10.Signal=GPIO_Output
PE11.Signal=LTDC_G3
PE12.Signal=LTDC_B4
PE13.Signal=LTDC_DE
PE14.Signal=LTDC_CLK
PE15.Signal=LTDC_R7
PE2.GPIO_Label=LED_USR
PE2.Signal=GPIO_Output
PE3.GPIO_Label=SD_EN
PE3.Signal=GPIO_Output
PE4.Signal=SAI1_FS_A
PE5.Signal=SAI1_SCK_A
PE6.Signal=SAI1_SD_A
PE9.GPIO_Label=BKLT_CTRL
PE9.Signal=S_TIM1_CH1
