cyfinfaza/RSC-LV3-Dash/(commit log)

2025-11-29 LCD connector, backlight, other work
    [CAN_Channel.kicad_sch, Interfaces.kicad_sch, LCD.kicad_sch, MCU.kicad_sch, Power.kicad_sch]
2025-12-22 preliminary complete schematic
    [CAN_Channel.kicad_sch, CubeMX-Pinout.csv, Interfaces.kicad_sch, LCD.kicad_sch, LV3-Dash.kicad_pcb, LV3-Dash.kicad_sch, MCU.kicad_sch, Power.kicad_sch]
2025-12-22 initial dimensions and placement
    [LV3-Dash.kicad_pcb]
2025-12-23 fix swd connector orientation, modify 12v input
    [LV3-Dash.kicad_pcb, Power.kicad_sch]
2025-12-23 basic layout organization, fix +VDDA typo
    [CAN_Channel.kicad_sch, Interfaces.kicad_sch, LCD.kicad_sch, LV3-Dash.kicad_pcb, LV3-Dash.kicad_sch, MCU.kicad_sch, Power.kicad_sch]
2025-12-24 full preliminary layout
    [LV3-Dash.kicad_pcb, MCU.kicad_sch]
2025-12-26 some preliminary routing
    [LV3-Dash.kicad_pcb]
2025-12-27 finalize connector placement, modify layout
    [Interfaces.kicad_sch, LCD.kicad_sch, LV3-Dash.kicad_pcb]
2025-12-28 3.3v regulator changes, GPIO output fixes, layout changes
    [Interfaces.kicad_sch, LCD.kicad_sch, LV3-Dash.kicad_pcb, MCU.kicad_sch, Power.kicad_sch]
2025-12-28 more preliminary routing, critical ground
    [LV3-Dash.kicad_pcb]
2025-12-30 finalized schematic, some routing
    [LV3-Dash.kicad_pcb, MCU.kicad_sch, pinout-formatted.csv, pinout.csv]
2025-12-30 fix duplicate LCD_EN pin, initial ZIF routing
    [LV3-Dash.kicad_pcb, MCU.kicad_sch]
2025-12-30 initial routing of all signals, 5v 3.3v not done
    [LV3-Dash.kicad_pcb]
2025-12-31 fully routed, needs cleanup, planes
    [LV3-Dash.kicad_pcb]
2026-01-01 trace cleanup, ground planes, silkscreen cleanup
    [LV3-Dash.kicad_pcb]
2026-01-04 fillets, graphics, other fixes
    [LV3-Dash-BOM-Exported.csv, LV3-Dash.kicad_pcb]
2026-01-11 FINAL FOR ORDER (4 Jan 2026)
    [LV3-Dash.kicad_pcb, bom.csv, designators.csv, positions.csv]
2026-03-30 r1 final (see changelog.md)
    [CAN_Channel.kicad_sch, Interfaces.kicad_sch, LCD.kicad_sch, LV3-Dash.kicad_pcb, LV3-Dash.kicad_sch, MCU.kicad_sch, Power.kicad_sch, bom.csv]
